brend3n/Pin-Transfer-Robot/Website/robot_pictures/3.JPG

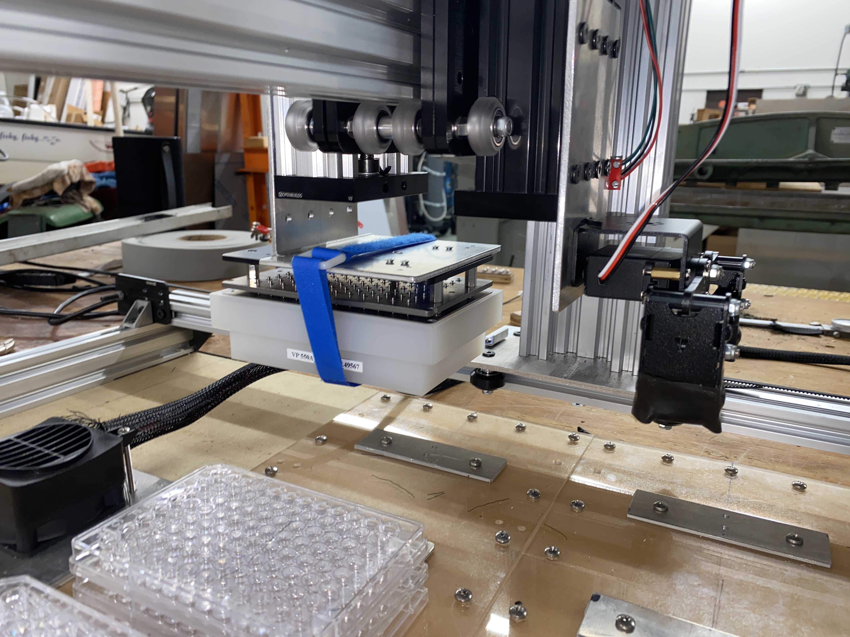
Website/robot_pictures/3.JPG
