brend3n/Pin-Transfer-Robot/Website/robot_pictures/1.JPG

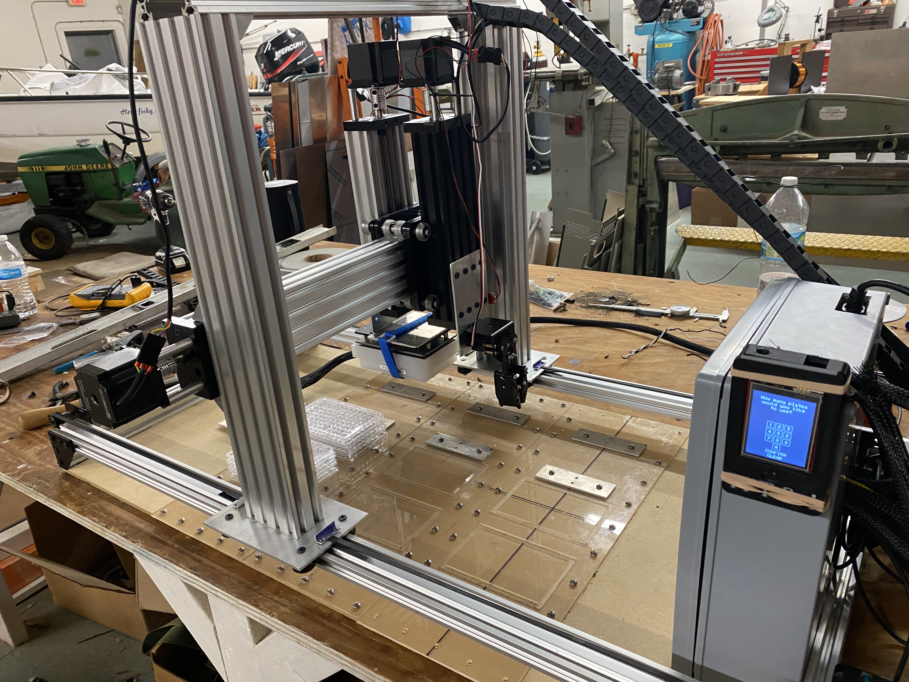
Website/robot_pictures/1.JPG
