brend3n/Pin-Transfer-Robot/README.md

# Pin-Transfer-Robot
Senior Design Project for Group H (Spring 2021 -> Fall 2021)

Checkout our website: https://brend3n.github.io/Group-H-Pin-Transfer-Robot-for-Chemical-Screening/
