brend3n/Pin-Transfer-Robot/Website/VIDEO_LINKS_FOR_IFRAME.txt

FINAL PRESENTATION POWERPOINT
<iframe width="560" height="315" src="https://www.youtube.com/embed/pB1D4pPYYJk" title="YouTube video player" frameborder="0" allow="accelerometer; autoplay; clipboard-write; encrypted-media; gyroscope; picture-in-picture" allowfullscreen></iframe>

FINAL PRESENTATION DEMO
<iframe width="560" height="315" src="https://www.youtube.com/embed/w0Isp63emys" title="YouTube video player" frameborder="0" allow="accelerometer; autoplay; clipboard-write; encrypted-media; gyroscope; picture-in-picture" allowfullscreen></iframe>

SHOWCASE VIDEO
<iframe width="560" height="315" src="https://www.youtube.com/embed/QKIKh7ecDXY" title="YouTube video player" frameborder="0" allow="accelerometer; autoplay; clipboard-write; encrypted-media; gyroscope; picture-in-picture" allowfullscreen></iframe>

MIDTERM DEMO
<iframe width="560" height="315" src="https://www.youtube.com/embed/RnHdhDJ4A94" title="YouTube video player" frameborder="0" allow="accelerometer; autoplay; clipboard-write; encrypted-media; gyroscope; picture-in-picture" allowfullscreen></iframe>

CDR PRESENTATION
<iframe width="560" height="315" src="https://www.youtube.com/embed/KsBtdRXCSqM" title="YouTube video player" frameborder="0" allow="accelerometer; autoplay; clipboard-write; encrypted-media; gyroscope; picture-in-picture" allowfullscreen></iframe>
