brend3n/Pin-Transfer-Robot/Website/robot_pictures/2.JPG

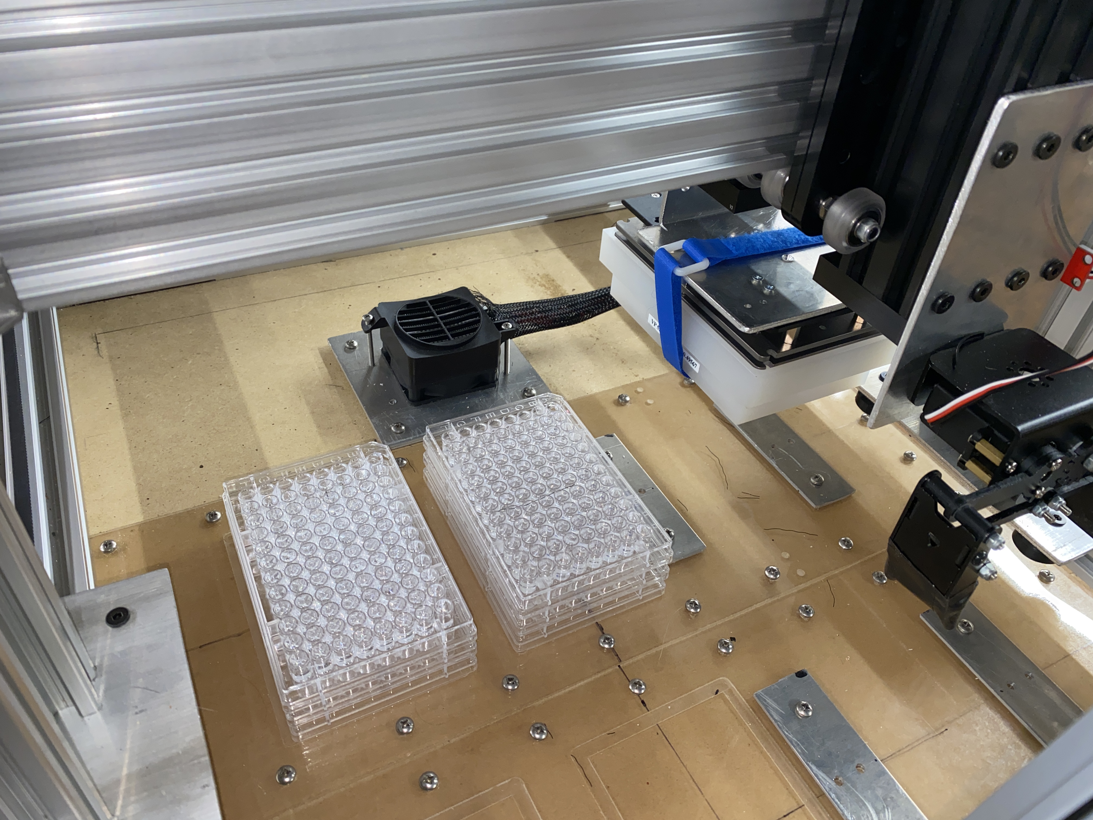
Website/robot_pictures/2.JPG
