brend3n/Pin-Transfer-Robot/test_data/Position_Testing.ods

Positions
 | Name | X | Y | Z1 | Z2
Gripper | Cell Input Stack | 2063 | 3423 | 0 | -1772
 | Cell Output Stack | 873 | 3351 | 0 | -1755
 | Chemical Input Stack | 2063 | 6091 | 0 | -1748
 | Chemical Output Stack | 885 | 6006 | 0 | -1854
Pin tool | Solution 1 | 1451 | 486 | -1680 | 0
 | Solution 2 | 855 | 417 | -1656 | 0
 | Solution 3 | 249 | 334 | -1657 | 0
 | Fan/Heater | 1908 | 3318 | -154 | 0
 | Cell Transfer Area Gripper | 1463 | 3358 | 0 | -1892
 | Chemical Transfer Area Gripper | 1467 | 6051 | 0 | -1748
 | Good Height value for base | -1881
 | Offset | 319
 | Wellplate Height
 | Pins just above well plate entrance |  |  | -1897
 | Pins at bottom of well plate but not pushed |  |  | -2128
 | Red = doesn’t matter
 | Cell Transfer Area Pintool X_LEFT | 846 | 3323
 | Cell Transfer Area Pintool X_RIGHT | 841 | 3267
 | Cell Transfer Area Pintool Y_LEFT | 845 | 3339
 | Cell Transfer Area Pintool Y_RIGHT | 845 | 3223
 | Cell Transfer Area X_MIDPOINT | 843.5
 | Cell Transfer Area Y_MIDPOINT | 3281
 | Chemical Transfer Area Pintool Y_RIGHT | 837 | 5875
 | Chemical Transfer Area Pintool Y_LEFT | 838 | 6023
 | Chemical Transfer Area Pintool X_LEFT | 838 | 5991
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
