brend3n/Pin-Transfer-Robot/PinToolRobot.ino

// Motors
#include <AccelStepper.h>
#include <MultiStepper.h>

// Servos
#include <Servo.h>

// LCD
#include <Adafruit_GFX.h>
#include <MCUFRIEND_kbv.h>
#include <TouchScreen.h>
#include <SoftwareSerial.h>


/*###########################################################################################*/
/* Motor Pin Definitions*/

// Motor driver type
#define interface  1

// Direction and Step pins for all motors
#define dirPinx   40
// #define stepPinx  41
#define stepPinx  52

#define dirPiny   38
#define stepPiny  39

#define dirPinz1  46
#define stepPinz1 47

#define dirPinz2  44
// #define stepPinz2 45
#define stepPinz2 35

/*###########################################################################################*/
/*Position Constants*/

#define Z_HIGH -100
#define Z_WASH_HIGH -800

#define drying_time_ms 10000
#define time_in_solution_ms 1000

#define time_for_full_absorption_of_chemicals_in_ms 1000
#define time_for_full_transfer_of_chemicals_in_ms 1000

#define STEPS_TO_MM  25.455
// #define Plate_Offset 290
#define Plate_Offset 319


// making this negative 
#define BASE_PLATE_STEPS -1881

#define PINS_ABOVE_WELL_PLATE_OPENING_STEPS -1897
#define PINS_AT_BOTTOM_OF_WELL_PLATE_STEPS  -2128

#define Cell_Input_Stack_X 2063
#define Cell_Input_Stack_Y -3423
#define Cell_Input_Stack_Z1 Z_HIGH
#define Cell_Input_Stack_Z2 BASE_PLATE_STEPS

#define Cell_Output_Stack_X 873
#define Cell_Output_Stack_Y -3351
#define Cell_Output_Stack_Z1 Z_HIGH
#define Cell_Output_Stack_Z2 BASE_PLATE_STEPS

#define Chemical_Input_Stack_X 2063
#define Chemical_Input_Stack_Y -6091
//#define Chemical_Output_Stack_X 899
//#define Chemical_Output_Stack_Y 6016

#define Chemical_Output_Stack_X 873
#define Chemical_Output_Stack_Y -6016

#define Cell_Transfer_Area_Gripper_X 1463
#define Cell_Transfer_Area_Gripper_Y -3358
#define Cell_Transfer_Area_Gripper_Z1 Z_HIGH
#define Cell_Transfer_Area_Gripper_Z2 BASE_PLATE_STEPS

#define Chemical_Transfer_Area_Gripper_X 1467
#define Chemical_Transfer_Area_Gripper_Y -6051
#define Chemical_Transfer_Area_Gripper_Z1 Z_HIGH
#define Chemical_Transfer_Area_Gripper_Z2 BASE_PLATE_STEPS

#define Cell_Transfer_Area_Pin_Tool_X 845
#define Cell_Transfer_Area_Pin_Tool_Y -3294

#define Chemical_Transfer_Area_Pin_Tool_X 841
#define Chemical_Transfer_Area_Pin_Tool_Y -5962

#define Solution_1_X 1451
#define Solution_1_Y -486
#define Solution_1_Z1 -1680
#define Solution_1_Z2 Z_HIGH

#define Solution_2_X 855
#define Solution_2_Y -417
#define Solution_2_Z1 -1656
#define Solution_2_Z2 Z_HIGH

#define Solution_3_X 249
#define Solution_3_Y -334
#define Solution_3_Z1 -1657
#define Solution_3_Z2 Z_HIGH

#define Fan_Heater_X 1908
#define Fan_Heater_Y -3318
#define Fan_Heater_Z1 -154
#define Fan_Heater_Z2 Z_HIGH


/*###########################################################################################*/
/*Servo Pins*/
#define SERVO_PIN 10

// Servo constants
#define CLOSE 50
#define OPEN  0

/*###########################################################################################*/
/* LCD Pin Definitions*/
#define YP A3  
#define XM A2  
#define YM 9   
#define XP 8 
TouchScreen ts = TouchScreen(XP, YP, XM, YM, 300);
#define LCD_CS A3
#define LCD_CD A2
#define LCD_WR A1
#define LCD_RD A0
#define LCD_RESET A4
MCUFRIEND_kbv tft;
#define BLACK 0x0000
#define WHITE 0xFFFF


/*###########################################################################################*/
/*Bluetooth*/

#define BLE_RX 22
#define BLE_TX 23


struct Ptr_Ble {
  void set_num_plates(int val);
  void update_state();
  void print_info();
  void send_data();
  void update_and_send();
  
  byte state;
  byte plate_number;
  byte num_plates;
  // enum State {CALIBRATING, CALIBRATED, SRCUNLOADED, RCPUNLOADED, PROCESSED, WASHED, DRIED, SRCLOADED, RCPLOADED, DONE};
  enum State {CALIBRATING, CALIBRATED, SRCUNLOADED, RCPUNLOADED, PROCESSED, SRCLOADED, RCPLOADED, WASHED, DRIED, DONE};

  Ptr_Ble() {
    Serial1.begin(9600);
    state = CALIBRATING;
    plate_number = 0;
    num_plates = -1;
  }
};

// Set this when the LCD gives it to you
void Ptr_Ble::set_num_plates(int val) {
  num_plates = val;
}

// helper
// update according to the states
// shown in the enum
void Ptr_Ble::update_state() {
  if (plate_number == num_plates) {
    if (state == DRIED) {
      state = DONE;
    } else if (state != DONE) {
      state++;
    }

    return;
  }

  if (state == DRIED) {
    if (plate_number == num_plates) {
      state = DONE;
      return;
    }

    plate_number++;
    state = SRCUNLOADED;
    return;
  }

  state++;
}

// for debugging purposes
void Ptr_Ble::print_info() {
  Serial.print("num_plates:"); Serial.print(num_plates); Serial.print(" state:"); Serial.println(state);
}

// helper
void Ptr_Ble::send_data() {
  Serial1.write(plate_number * 10 + state);
  // Just for good measure.
  delay(100);
}

void Ptr_Ble::update_and_send() {
  update_state();
  send_data();
}

void Ptr_Ble::reset() {
  state = CALIBRATING;
  plate_number = 0;
  num_plates = -1;
}

Ptr_Ble ptr_ble;

/*###########################################################################################*/
/*Other Pin Definitions*/

// Limit switch pins definitions
#define y_switch 26
#define x_switch 29
#define z1_switch 25
#define z2_switch 24

// Pins for fan and heater N-Channel MOSFET gate pin
#define fan_pin         34
#define heater_pin      36

/*###########################################################################################*/
/*CONTSTANTS*/

// Motor speeds
#define SPEED_GANTRY 300
#define SPEED_Y      400
#define SPEED_Z      150

#define SPEED_Z1     150
#define SPEED_Z2     150


#define ACCELERATION_Y 200
#define ACCELERATION_GANTRY 200

// Speed of all the motors
#define MAX_SPEED             500
#define MAX_ACCELERATION      100

#define DELAY                 500 // Half a second

#define plate_height_in_steps 1024

#define plate_height_in_mm    1024

#define steps_per_mm          1024

#define heat_and_fan_delay    5000

// Change to false to do polling
#define INTERRUPTS_ENABLED false



/*###########################################################################################*/

// Instantiating motor driver objects
AccelStepper gantry   = AccelStepper(interface, stepPinx, dirPinx);
AccelStepper motor_y  = AccelStepper(interface, stepPiny, dirPiny);
AccelStepper motor_z1 = AccelStepper(interface, stepPinz1, dirPinz1);
AccelStepper motor_z2 = AccelStepper(interface, stepPinz2, dirPinz2);

Servo servo = Servo();

/*###########################################################################################*/

// Converts a distance in mm to steps
long convert_mm_to_steps(float mm){
  long steps = mm * STEPS_TO_MM;
  return steps;
}

// Prints the current position of each motor to the serial for testing and getting position values for hard coding.
void print_current_position(){
    Serial.println("X Position: " + String(gantry.currentPosition()) +"\nY Position: " + String(motor_y.currentPosition()) + "\nZ1 Position: " + String(motor_z1.currentPosition()) +"\nZ2 Position: " + String(motor_z2.currentPosition()) + "\n"); 
}

// WORKING
void set_pins(){

  // Polling inputs
  pinMode(x_switch, INPUT);
  pinMode(y_switch, INPUT);
  pinMode(z1_switch, INPUT);
  pinMode(z2_switch, INPUT);

  pinMode(heater_pin, INPUT);
  pinMode(fan_pin, INPUT);

  // Set up servo
  servo.attach(SERVO_PIN);  
}

// Configure each motor
void configure_motors(){

    // Set maxmium speeds
    gantry.setMaxSpeed(MAX_SPEED);
    motor_y.setMaxSpeed(MAX_SPEED);
    motor_z1.setMaxSpeed(MAX_SPEED);
    motor_z2.setMaxSpeed(MAX_SPEED);

    // Set acceleration
    gantry.setAcceleration(ACCELERATION_GANTRY);
    motor_y.setAcceleration(ACCELERATION_Y);
    motor_z1.setAcceleration(MAX_ACCELERATION);
    motor_z2.setAcceleration(MAX_ACCELERATION);
}

void set_acceleration(int acceleration){
    // Set acceleration
    gantry.setAcceleration(acceleration);
    motor_y.setAcceleration(acceleration);
    motor_z1.setAcceleration(acceleration);
    motor_z2.setAcceleration(acceleration);
}

// Calibrates a single motor given by &motor and a limit switch
long calibrate_motor(AccelStepper *motor, int limit_switch, short dir){

    long steps;
    Serial.println("Start Position:");

    // For testing
    print_current_position();
    
    // Set the current speed and run until the limit switch is hit
    motor->setSpeed(175 * dir);
    while (digitalRead(limit_switch) != LOW){
        motor->runSpeed();
    }

    // Distance from starting position to limit switch
    // Negative because reference 0 is at limit switch and all of other distances are negative relative to the limit switch
    steps = -1*motor->currentPosition();

    // For testing
    Serial.println("Steps taken to reach limit switch: " + String(steps));
    // Stop the motor and store the current position
    motor->stop();
    motor->setCurrentPosition(0);

    // For testing
    Serial.println("End Position:");
    print_current_position();

    // Move the motor off the limit switch
    
    motor->move(50 * -1 * dir);
    motor->runToPosition();

    return steps;
}

// Shows the motor's (x,y,z1,z2) coordinates from where the motor starts before calibration

void calibrate_motors(){ 

  gripper(CLOSE, servo);
  int val;

  Serial.println("Calibrating Z1");
  long z1_start = calibrate_motor(&motor_z1, z1_switch, 1); 

  Serial.println("Calibrating Z2");
  long z2_start = calibrate_motor(&motor_z2, z2_switch, 1); 

  Serial.println("Calibrating Y");
  long y_start = calibrate_motor(&motor_y, y_switch, 1);

  Serial.println("Calibrating gantry");
  long x_start = calibrate_motor(&gantry , x_switch, -1);


  gantry.runToNewPosition(1000);
  gripper(OPEN,servo);
}

// Test code for verifying limit switches are working
void test_limit_switches(){
   Serial.println("X: " + String(digitalRead(x_switch)));
   Serial.println("Y: " + String(digitalRead(y_switch)));
   Serial.println("Z1: " + String(digitalRead(z1_switch)));
   Serial.println("Z2: " + String(digitalRead(z2_switch)));
   Serial.println();
   delay(1000);
}

/*###########################################################################################*/
/*Servo Functions*/

void gripper(int a, Servo x)
{
  int currentPos =  x.read();
  if (currentPos > a)
  {
    for (int angle = currentPos; angle >= a; angle--) {
      x.write(angle);
      delay(15);
    }
  }
  else if (currentPos < a)
  {
    for (int angle = currentPos; angle <= a; angle++) {
      x.write(angle);
      delay(15);
    }
  }
}

// Open gripper arms enough to grab one plate
void open_gripper(){
  gripper(OPEN,servo);
}

// Close gripper arms enough to secure one plate
void close_gripper(){
  gripper(CLOSE, servo);
}

/*###########################################################################################*/
/*Robot Functions*/

// Moves each motor to a given position starting with the x-axis
void move_to_coordinate_x_first(long x, long y, long z1, long z2){
// void move_to_coordinate_x_first(long *coordinates){

  motor_z1.setSpeed(SPEED_Z);
  motor_z2.setSpeed(SPEED_Z);
  gantry.setSpeed(SPEED_GANTRY);
  motor_y.setSpeed(SPEED_Y);
  

  gantry.runToNewPosition(x);
  motor_y.runToNewPosition(y);
  motor_z1.runToNewPosition(z1);
  motor_z2.runToNewPosition(z2);
  
}
// Moves each motor to a given position starting with the z-axis to prevent the pintool/gripper from hitting anything on the workspace
void move_to_coordinate_z_first(long x, long y, long z1, long z2){
// void move_to_coordinate_z_first(long *coordinates){

  motor_z1.setSpeed(SPEED_Z);
  motor_z2.setSpeed(SPEED_Z);
  gantry.setSpeed(SPEED_GANTRY);
  motor_y.setSpeed(SPEED_Y);

  motor_z1.runToNewPosition(z1);
  motor_z2.runToNewPosition(z2);
  gantry.runToNewPosition(x);
  motor_y.runToNewPosition(y);
}

// Take plate from a stack
// stack ==  
//    false for cell
//    true for chemical
void take_from_stack(boolean stack, int height_to_pick_from){

  // chemical stack
  if (stack){
    
    // Position gripper over stack
    // z1 is set to 0 because we dont know height yet of first plate to grab so bring it all the way up
    move_to_coordinate_x_first(Chemical_Input_Stack_X, Chemical_Input_Stack_Y, Z_HIGH, height_to_pick_from);
    // move_to_coordinate_x_first(chemical_stack_1);
    close_gripper();
    // z2 set to 0 to bring plate up ... might change to something else later but 0 for now
    // Moving up gripper
    move_to_coordinate_z_first(Chemical_Input_Stack_X, Chemical_Input_Stack_Y, Z_HIGH, Z_HIGH);
    // Move to pin transfer area
    move_to_coordinate_x_first(Chemical_Transfer_Area_Gripper_X, Chemical_Transfer_Area_Gripper_Y, Z_HIGH, BASE_PLATE_STEPS);
    open_gripper();
    move_to_coordinate_x_first(Chemical_Transfer_Area_Gripper_X, Chemical_Transfer_Area_Gripper_Y, Z_HIGH, Z_HIGH);
  }
  // cell stack
  else{

    // Position gripper over stack
    // z1 is set to 0 because we dont know height yet of first plate to grab so bring it all the way up
    move_to_coordinate_x_first(Cell_Input_Stack_X, Cell_Input_Stack_Y, Z_HIGH, height_to_pick_from);
    close_gripper();
    // z2 set to 0 to bring plate up ... might change to something else later but 0 for now
    // Moving up gripper
    move_to_coordinate_z_first(Cell_Input_Stack_X, Cell_Input_Stack_Y, Z_HIGH, Z_HIGH);
    // Move to pin transfer area
    move_to_coordinate_x_first(Cell_Transfer_Area_Gripper_X, Cell_Transfer_Area_Gripper_Y, Z_HIGH, BASE_PLATE_STEPS);
    open_gripper();
    move_to_coordinate_x_first(Cell_Transfer_Area_Gripper_X, Cell_Transfer_Area_Gripper_Y, Z_HIGH, Z_HIGH);
  }
}

// TODO
// Put a plate onto a stack
void push_onto_stack(int stack, int height_to_put_on){

  // chemical stack
  if (stack){
    // Position gripper over stack
    // z1 is set to 0 because we dont know height yet of first plate to grab so bring it all the way up
    move_to_coordinate_x_first(Chemical_Transfer_Area_Gripper_X, Chemical_Transfer_Area_Gripper_Y, Z_HIGH, BASE_PLATE_STEPS);
    close_gripper();
    // z2 set to 0 to bring plate up ... might change to something else later but 0 for now
    // Moving up gripper
    move_to_coordinate_z_first(Chemical_Transfer_Area_Gripper_X, Chemical_Transfer_Area_Gripper_Y, Z_HIGH, Z_HIGH);
    // Move to pin transfer area
    move_to_coordinate_x_first(Chemical_Output_Stack_X, Chemical_Output_Stack_Y, Z_HIGH, height_to_put_on);
    open_gripper();
    move_to_coordinate_x_first(Chemical_Output_Stack_X, Chemical_Output_Stack_Y, Z_HIGH, Z_HIGH);
  }
  // cell stack
  else{
    // Position gripper over stack
    // z1 is set to 0 because we dont know height yet of first plate to grab so bring it all the way up
    move_to_coordinate_x_first(Cell_Transfer_Area_Gripper_X, Cell_Transfer_Area_Gripper_Y, Z_HIGH, BASE_PLATE_STEPS);
    close_gripper();
    // z2 set to 0 to bring plate up ... might change to something else later but 0 for now
    // Moving up gripper
    move_to_coordinate_z_first(Cell_Transfer_Area_Gripper_X, Cell_Transfer_Area_Gripper_Y, Z_HIGH, Z_HIGH);
    // Move to pin transfer area
    move_to_coordinate_x_first(Cell_Output_Stack_X, Cell_Output_Stack_Y, Z_HIGH, height_to_put_on);
    open_gripper();
    move_to_coordinate_x_first(Cell_Output_Stack_X, Cell_Output_Stack_Y, Z_HIGH, Z_HIGH);
  }
}

// TODO
void do_wash(int wash_step){

  set_acceleration(200);

  
  // Solution 1
  if(wash_step == 0){
    // Move to Solution 1
    for(int i = 0; i < 3; i++){
      
      move_to_coordinate_x_first(Solution_1_X, Solution_1_Y, Solution_1_Z1, Z_HIGH);
      delay(time_in_solution_ms);
      move_to_coordinate_x_first(Solution_1_X, Solution_1_Y, Z_WASH_HIGH, Z_HIGH);  
    }
  }
  // Solution 2
  else if(wash_step == 1){
    // Move to Solution 2
    for(int i = 0; i < 3;i++){
      move_to_coordinate_x_first(Solution_2_X, Solution_2_Y, Solution_2_Z1, Z_HIGH);
      delay(time_in_solution_ms);
      move_to_coordinate_x_first(Solution_2_X, Solution_2_Y, Z_WASH_HIGH, Z_HIGH);     
    }
  }
  // Solution 3
  else if(wash_step == 2){
    // Move to Solution 3
    for(int i = 0;i < 3; i++){
      move_to_coordinate_x_first(Solution_3_X, Solution_3_Y, Solution_3_Z1, Z_HIGH);
      delay(time_in_solution_ms);
      move_to_coordinate_x_first(Solution_3_X, Solution_3_Y, Z_WASH_HIGH, Z_HIGH);   
    }
  }

  set_acceleration(MAX_ACCELERATION);
}

// WORKS
// Allows fan to draw from power supply
void fan_on(){
  digitalWrite(fan_pin, HIGH);
}

// WORKS
// Allows heater to draw from power supply
void heat_on(){
  digitalWrite(heater_pin, HIGH);
}

// WORKS
// Turns off the fan.
void fan_off(){
  digitalWrite(fan_pin, LOW);
}

// WORKS
// Turns off the heater.
void heat_off(){
  digitalWrite(heater_pin, LOW);
}

// WORKS
// Allows fan and hearter to draw from power supply
void do_fan_and_heat(){
  
  // Move pin tool over the fan
  move_to_coordinate_x_first(Fan_Heater_X, Fan_Heater_Y, Fan_Heater_Z1, Z_HIGH);
  fan_on();
  heat_on();
  delay(drying_time_ms);
  heat_off();
  fan_off();
  delay(drying_time_ms);
  move_to_coordinate_x_first(Fan_Heater_X , Fan_Heater_Y, Z_HIGH, Z_HIGH);
}

// TODO
// Perform a single pin transfer and bring the pin back to its starting position.
void do_pin_transfer(int pin_depth){

  long depth =  PINS_ABOVE_WELL_PLATE_OPENING_STEPS - convert_mm_to_steps(pin_depth);
  

  // Move to chemical plate to absorb chemicals in pin tool also dipping pin tool in chemical plate
  move_to_coordinate_x_first(Chemical_Transfer_Area_Pin_Tool_X,Chemical_Transfer_Area_Pin_Tool_Y, depth, Z_HIGH);
  delay(time_for_full_absorption_of_chemicals_in_ms);

  // Moving pin tool out of chemical plate
  move_to_coordinate_z_first(Chemical_Transfer_Area_Pin_Tool_X, Chemical_Transfer_Area_Pin_Tool_Y, Z_HIGH,Z_HIGH);
  // Moving pin tool to cell plate and transfer chemicals to cells
  move_to_coordinate_x_first(Cell_Transfer_Area_Pin_Tool_X, Cell_Transfer_Area_Pin_Tool_Y, depth, Z_HIGH);
  delay(time_for_full_transfer_of_chemicals_in_ms);
  // Moving pin tool out of cell plate
  move_to_coordinate_z_first(Cell_Transfer_Area_Pin_Tool_X, Cell_Transfer_Area_Pin_Tool_Y, Z_HIGH, Z_HIGH);

}

// Wash the pin tool.
void wash_pin_tool(boolean * wash_steps){
  // 1. Move pin tool to wash step linear actuator
  for(int wash_step = 0; wash_step < 3; wash_step++){
    if(wash_steps[wash_step]){
      do_wash(wash_step);
    }
  }
}


void do_cycle(boolean *wash_steps, int pin_depth, int grab_height, int stack_height, int plateNum){
  progressScreen(plateNum, "Input");
  take_from_stack(true, grab_height);
  ptr_ble.update_and_send();
  take_from_stack(false, grab_height);
  ptr_ble.update_and_send();

  progressScreen(plateNum, "Transfer");
  do_pin_transfer(pin_depth);
  ptr_ble.update_and_send();

  progressScreen(plateNum, "Output");
  push_onto_stack(false, stack_height);
  ptr_ble.update_and_send();
  push_onto_stack(true, stack_height);
  ptr_ble.update_and_send();

  progressScreen(plateNum, "Wash");
  wash_pin_tool(wash_steps);
  ptr_ble.update_and_send();

  progressScreen(plateNum, "Dry");
  do_fan_and_heat();
  ptr_ble.update_and_send();
  
}

void run_all_cycles(boolean * wash_steps, short num_plates, int pin_depth ){

  int grab_height = (BASE_PLATE_STEPS + (Plate_Offset * (num_plates - 1)));
  int stack_height = BASE_PLATE_STEPS;
  
  for(int i = 0; i < num_plates; i++){
    
    do_cycle(wash_steps, pin_depth, grab_height, stack_height , i+1);

    // Update where the next plate is located at.
    grab_height -= Plate_Offset;
    stack_height += Plate_Offset;

  }
}

/*###########################################################################################*/
/*LCD Functions*/
void lcd_startup()
{
  tft.reset();
  uint16_t identifier = tft.readID();
  tft.begin(identifier);
  tft.setRotation(2);
  tft.setTextColor(WHITE);
  tft.setTextSize(2);
  pinMode(13, OUTPUT);
}

void greeting()
{
  tft.fillScreen(BLACK);
  tft.setCursor(40,120);
  tft.println("Welcome to the");
  tft.setCursor(43,140);
  tft.println("automated Pin");
  tft.setCursor(40,160);
  tft.println("Transfer Tool!");
  delay(3000);
}

// Screen setup for plate input
void plateNumberSetup()
{
  // Reset screen
  tft.fillScreen(BLACK);
  // Instructions
  tft.setCursor(33,20);
  tft.println("How many plates");
  tft.setCursor(38,40);
  tft.println("would you like");
  tft.setCursor(75,60);
  tft.println("to use?");
  
  // Buttons
  tft.drawRect(70, 135, 30, 30, WHITE);
  tft.setCursor(80,143);
  tft.println("1");
  tft.drawRect(105, 135, 30, 30, WHITE);
  tft.setCursor(115,143);
  tft.println("2");
  tft.drawRect(140, 135, 30, 30, WHITE);
  tft.setCursor(150,143);
  tft.println("3");
  tft.drawRect(70, 170, 30, 30, WHITE);
  tft.setCursor(80,178);
  tft.println("4");
  tft.drawRect(105, 170, 30, 30, WHITE);
  tft.setCursor(115,178);
  tft.println("5");
  tft.drawRect(140, 170, 30, 30, WHITE);
  tft.setCursor(150,178);
  tft.println("6");
  tft.drawRect(70, 205, 30, 30, WHITE);
  tft.setCursor(80,213);
  tft.println("7");
  tft.drawRect(105, 205, 30, 30, WHITE);
  tft.setCursor(115,213);
  tft.println("8");
  tft.drawRect(140, 205, 30, 30, WHITE);
  tft.setCursor(150,213);
  tft.println("9");
  tft.drawRect(105, 240, 30, 30, WHITE);
  tft.setCursor(115,248);
  tft.println("0");
  tft.setCursor(80, 278);
  tft.println("CONFIRM");
  tft.setCursor(90, 300);
  tft.println("CLEAR");
}

// User inputs number of plates they wish to use
int plateNumberInput()
{
  int plateNum = -1;
  while (true)
  {
    digitalWrite(13, HIGH);
    TSPoint point = ts.getPoint();
    digitalWrite(13, LOW);
    pinMode(XM, OUTPUT);
    pinMode(YP, OUTPUT);
    if (point.z  >= 200 && point.z <= 1500)
    {
      int x = map(point.x, 78, 951, 0, 320);
      int y = map(point.y, 96, 921, 0, 240);

      if (x >= 185 && x <= 220 && y >= 109 && y <= 127)
      {
        tft.fillRect(105, 90, 30, 30, BLACK);
        plateNum = 1;
        tft.setCursor(115, 100);
        tft.print("1");
        delay(1000);
      }
      else if (x >= 140 && x <= 175 && y >= 107 && y <= 129)
      {
        tft.fillRect(105, 90, 30, 30, BLACK);
        plateNum = 2;
        tft.setCursor(115, 100);
        tft.print("2");
        delay(1000);
      }
      else if (x >= 95 && x <= 132 && y >= 107 && y <= 129)
      {
        tft.fillRect(105, 90, 30, 30, BLACK);
        tft.setCursor(115, 100);
        tft.print("3");
        plateNum = 3;
        delay(1000);
      }
      else if (x >= 185 && x <= 220 && y >= 80 && y <= 101)
      {
        tft.fillRect(105, 90, 30, 30, BLACK);
        tft.setCursor(115, 100);
        tft.print("4");
        plateNum = 4;
        delay(1000);
      }
      else if (x >= 140 && x <= 175 && y >= 80 && y <= 101)
      {
        tft.fillRect(105, 90, 30, 30, BLACK);
        tft.setCursor(115, 100);
        tft.print("5");
        plateNum = 5;
        delay(1000);
      }
      else if (x >= 95 && x <= 132 && y >= 80 && y <= 101)
      {
        tft.fillRect(105, 90, 30, 30, BLACK);
        tft.setCursor(115, 100);
        tft.print("6");
        plateNum = 6;
        delay(1000);
      }
      else if (x >= 185 && x <= 220 && y >= 55 && y <= 75)
      {
        tft.fillRect(105, 90, 30, 30, BLACK);
        tft.setCursor(115, 100);
        tft.print("7");
        plateNum = 7;
        delay(1000);
      }
      else if (x >= 140 && x <= 175 && y >= 55 && y <= 75)
      {
        tft.fillRect(105, 90, 30, 30, BLACK);
        tft.setCursor(115, 100);
        tft.print("8");
        plateNum = 8;
        delay(1000);
      }
      else if (x >= 95 && x <= 132 && y >= 55 && y <= 75)
      {
        tft.fillRect(105, 90, 30, 30, BLACK);
        tft.setCursor(115, 100);
        tft.print("9");
        plateNum = 9;
        delay(1000);
      }
      else if (x >= 140 && x <= 175 && y >= 28 && y <= 50)
      {
        tft.fillRect(105, 90, 30, 30, BLACK);
        tft.setCursor(115, 100);
        tft.print("0");
        plateNum = 0;
        delay(1000);
      }
      else if (x >= 103 && x <= 208 && y >= 13 && y <= 22 && plateNum != -1)
        break;
      else if (x >= 120 && x <= 195 && y >= -2 && y <= 6)
      {
        plateNum = -1;
        tft.fillRect(105, 90, 30, 30, BLACK);
      }
    }
  }

  ptr_ble.set_num_plates(plateNum);

  return plateNum;
}

void depthSetup()
{
  // Reset screen
  tft.fillScreen(BLACK);
  // Instructions
  tft.setCursor(33,20);
  tft.println("How deep would");
  tft.setCursor(13,40);
  tft.println("you like to insert");
  tft.setCursor(40,60);
  tft.println("the pin tool?");
  
  // Buttons
  tft.drawRect(70, 135, 30, 30, WHITE);
  tft.setCursor(80,143);
  tft.println("1");
  tft.drawRect(105, 135, 30, 30, WHITE);
  tft.setCursor(115,143);
  tft.println("2");
  tft.drawRect(140, 135, 30, 30, WHITE);
  tft.setCursor(150,143);
  tft.println("3");
  tft.drawRect(70, 170, 30, 30, WHITE);
  tft.setCursor(80,178);
  tft.println("4");
  tft.drawRect(105, 170, 30, 30, WHITE);
  tft.setCursor(115,178);
  tft.println("5");
  tft.drawRect(140, 170, 30, 30, WHITE);
  tft.setCursor(150,178);
  tft.println("6");
  tft.drawRect(70, 205, 30, 30, WHITE);
  tft.setCursor(80,213);
  tft.println("7");
  tft.drawRect(105, 205, 30, 30, WHITE);
  tft.setCursor(115,213);
  tft.println("8");
  tft.drawRect(140, 205, 30, 30, WHITE);
  tft.setCursor(150,213);
  tft.println("9");
  tft.drawRect(105, 240, 30, 30, WHITE);
  tft.setCursor(115,248);
  tft.println("0");
  tft.setCursor(80, 278);
  tft.println("CONFIRM");
  tft.setCursor(90, 300);
  tft.println("CLEAR");
}

int depthInput()
{
  String depth = "";
  int x_cursor = 115;
  while (true)
  {
    digitalWrite(13, HIGH);
    TSPoint point = ts.getPoint();
    digitalWrite(13, LOW);
    pinMode(XM, OUTPUT);
    pinMode(YP, OUTPUT);
    if (point.z  >= 200 && point.z <= 1500)
    {     
      int x = map(point.x, 78, 951, 0, 320);
      int y = map(point.y, 96, 921, 0, 240);

      if (x >= 185 && x <= 220 && y >= 109 && y <= 127)
      {
        tft.fillRect(0, 90, 240, 30, BLACK);
        tft.setCursor(x_cursor, 100);
        x_cursor -= 7;
        depth.concat("1");
        tft.print(depth);
        delay(1000);
      }
      else if (x >= 140 && x <= 175 && y >= 107 && y <= 129)
      {
        tft.fillRect(0, 90, 240, 30, BLACK);
        tft.setCursor(x_cursor, 100);
        x_cursor -= 7;
        depth.concat("2");
        tft.print(depth);
        delay(1000);
      }
      else if (x >= 95 && x <= 132 && y >= 107 && y <= 129)
      {
        tft.fillRect(0, 90, 240, 30, BLACK);
        tft.setCursor(x_cursor, 100);
        x_cursor -= 7;
        depth.concat("3");
        tft.print(depth);
        delay(1000);
      }
      else if (x >= 185 && x <= 220 && y >= 80 && y <= 101)
      {
        tft.fillRect(0, 90, 240, 30, BLACK);
        tft.setCursor(x_cursor, 100);
        x_cursor -= 7;
        depth.concat("4");
        tft.print(depth);
        delay(1000);
      }
      else if (x >= 140 && x <= 175 && y >= 80 && y <= 101)
      {
        tft.fillRect(0, 90, 240, 30, BLACK);
        tft.setCursor(x_cursor, 100);
        x_cursor -= 7;
        depth.concat("5");
        tft.print(depth);
        delay(1000);
      }
      else if (x >= 95 && x <= 132 && y >= 80 && y <= 101)
      {
        tft.fillRect(0, 90, 240, 30, BLACK);
        tft.setCursor(x_cursor, 100);
        x_cursor -= 7;
        depth.concat("6");
        tft.print(depth);
        delay(1000);
      }
      else if (x >= 185 && x <= 220 && y >= 55 && y <= 75)
      {
        tft.fillRect(0, 90, 240, 30, BLACK);
        tft.setCursor(x_cursor, 100);
       x_cursor -= 7;
        depth.concat("7");
        tft.print(depth);
        delay(1000);
      }
      else if (x >= 140 && x <= 175 && y >= 55 && y <= 75)
      {
        tft.fillRect(0, 90, 240, 30, BLACK);
        tft.setCursor(x_cursor, 100);
        x_cursor -= 7;
        depth.concat("8");
        tft.print(depth);
        delay(1000);
      }
      else if (x >= 95 && x <= 132 && y >= 55 && y <= 75)
      {
        tft.fillRect(0, 90, 240, 30, BLACK);
        tft.setCursor(x_cursor, 100);
        x_cursor -= 7;
        depth.concat("9");
        tft.print(depth);
        delay(1000);
      }
      else if (x >= 140 && x <= 175 && y >= 28 && y <= 50)
      {
        tft.fillRect(0, 90, 240, 30, BLACK);
        tft.setCursor(x_cursor, 100);
        x_cursor -= 7;
        depth.concat("0");
        tft.print(depth);
        delay(1000);
      }
      else if (x >= 103 && x <= 208 && y >= 13 && y <= 22 && depth != "")
        break;
      else if (x >= 120 && x <= 195 && y >= -2 && y <= 6)
      {
        x_cursor = 115;
        depth = "";
        tft.fillRect(0, 90, 240, 30, BLACK);
      }
    }
  }
  return depth.toInt();
}

void washStepSetup()
{
  // Reset screen
  tft.fillScreen(BLACK);
  // Instructions
  tft.setCursor(19, 20);
  tft.println("Select which wash");
  tft.setCursor(30, 40);
  tft.println("steps you would");
  tft.setCursor(47, 60);
  tft.println("like to use.");

  // Check boxes
  tft.drawRect(150, 115, 30, 30, WHITE);
  tft.drawRect(150, 165, 30, 30, WHITE);
  tft.drawRect(150, 215, 30, 30, WHITE);

  // Wash step numbers
  tft.setCursor(55, 123);
  tft.print("1 -----");
  tft.setCursor(55, 173);
  tft.print("2 -----");
  tft.setCursor(55, 223);
  tft.print("3 -----");
  tft.setCursor(80, 280);
  tft.print("CONFIRM");
}

void washStepInput(bool * steps)
{
  steps[0] = false;
  steps[1] = false;
  steps[2] = false;
      
  while (true)
  {
    digitalWrite(13, HIGH);
    TSPoint point = ts.getPoint();
    digitalWrite(13, LOW);
    pinMode(XM, OUTPUT);
    pinMode(YP, OUTPUT);
    if (point.z  >= 200 && point.z <= 1500)
    {
      int x = map(point.x, 78, 951, 0, 320);
      int y = map(point.y, 96, 921, 0, 240);

      if (x >= 83 && x <= 119 && y >= 122 && y <= 145)
      {
        if (!steps[0])
        {
          tft.drawLine(151, 116, 178, 143, WHITE);
          tft.drawLine(178, 116, 151, 143, WHITE);
          steps[0] = true;
          delay(500);
        }
        else
        {
          tft.fillRect(151, 116, 28, 28, BLACK);
          steps[0] = false;
          delay(500);
        }         
      }
      else if (x >= 83 && x <= 119 && y >= 83 && y <= 108)
      { 
        if (!steps[1])
        {
          tft.drawLine(151, 166, 178, 193, WHITE);
          tft.drawLine(178, 166, 151, 193, WHITE);
          steps[1] = true;
          delay(500);
        }
        else
        {
          tft.fillRect(151, 166, 28, 28, BLACK);
          steps[1] = false;
          delay(500);
        }      
      }
      else if (x >= 83 && x <= 119 && y >= 45 && y <= 70)
      {  
        if (!steps[2])
        {
          tft.drawLine(151, 216, 178, 243, WHITE);
          tft.drawLine(178, 216, 151, 243, WHITE);
          steps[2] = true;
          delay(500);
        }
        else
        {
          tft.fillRect(151, 216, 28, 28, BLACK);
          steps[2] = false;
          delay(500);
        }     
      }
      else if (x >= 105 && x <= 211 && y >= 10 && y <= 22) 
        break;
    }
  }
}

bool paramCheck(int plateNum, int depth, bool * steps)
{
  tft.fillScreen(BLACK);
  tft.setCursor(19, 20);
  tft.println("Accept parameters");
  tft.setCursor(50, 40);
  tft.println("and continue");
  tft.setCursor(62, 60);
  tft.println("to the pin");
  tft.setCursor(20, 80);
  tft.println("transfer process?");

  tft.setCursor(0, 140);
  tft.print("Number of Plates: ");
  tft.print(plateNum);
  tft.setCursor(0, 160);
  tft.print("Pin Tool Depth: ");
  tft.print(depth);
  tft.setCursor(0, 180);
  tft.print("Wash Steps: ");
  if (steps[0] == 1)
    tft.print("1 ");
  if (steps[1] == 1)
    tft.print("2 ");
  if (steps[2] == 1)
    tft.print("3 ");

  tft.setCursor(20, 240);
  tft.print("CONFIRM");
  tft.setCursor(173, 240);
  tft.print("REDO");

  while (true)
  {
    digitalWrite(13, HIGH);
    TSPoint point = ts.getPoint();
    digitalWrite(13, LOW);
    pinMode(XM, OUTPUT);
    pinMode(YP, OUTPUT);
    if (point.z  >= 200 && point.z <= 1500)
    {
      int x = map(point.x, 78, 951, 0, 320);
      int y = map(point.y, 96, 921, 0, 240);

      if (x >= 182 && x <= 283 && y >= 37 && y <= 50)
        return true;
      else if (x >= 35 && x <= 93 && y >= 37 && y <= 50)
        return false;
    }
  }
  return false;
}

void progressScreen(int plateNum, String location)
{
  tft.fillRect(154, 115, 30, 30, BLACK);
  tft.fillRect(130, 155, 120, 30, BLACK);
  tft.setCursor(70, 120);
  tft.print("Plate #");
  tft.print(plateNum);
  tft.setCursor(20, 160);
  tft.print("Location: ");
  tft.print(location);
}

void redo()
{
  tft.fillScreen(BLACK);
  tft.setCursor(25, 120);
  tft.print("Run more plates?");
  tft.setCursor(80, 170);
  tft.print("CONFIRM");
  tft.drawRect(75, 165, 92, 25, WHITE);

  while (true)
  {
    digitalWrite(13, HIGH);
    TSPoint point = ts.getPoint();
    digitalWrite(13, LOW);
    pinMode(XM, OUTPUT);
    pinMode(YP, OUTPUT);
    if (point.z  >= 200 && point.z <= 1500)
    {
      int x = map(point.x, 78, 951, 0, 320);
      int y = map(point.y, 96, 921, 0, 240);
      Serial.println(x);
      Serial.println(y);
      Serial.println();
      if (x >= 106 && x <= 214 && y >= 90 && y <= 105)
        break;
    }
  }
}

/*###########################################################################################*/

void run_startup(){
  // TESTING: Begin serial connection for debugging
  Serial.begin(9600);

  // LCD Startup function
  lcd_startup();
  greeting();

  // Set the state of any pins used as inputs
  set_pins();

  // Set the max speed and acceleration values for each motor
  configure_motors();

//   Serial.println("Press x_limit_switch to start calibration");
//   while(true){
//     servo.write(0);
//       Serial.println("Starting calibration.");
//       break;
//     }
//   }
}


void test_directions(){


  motor_z2.setCurrentPosition(0);
  gripper(OPEN, servo);
  motor_z2.runToNewPosition(-50);

  delay(2000);
  gripper(CLOSE, servo);
  
  motor_z2.runToNewPosition(50);
 
delay(2000);



  
}
void setup() {
  Serial.begin(9600);
  run_startup();
}

void loop() {
  ptr_ble.reset();

  int numPlates;
  int depth;
  bool steps[3];
  while (true)
  {
    tft.fillScreen(BLACK);
    plateNumberSetup();
    numPlates = plateNumberInput();
    depthSetup();
    depth = depthInput();
    washStepSetup();
    washStepInput(steps);
    if (paramCheck(numPlates, depth, steps))
      tft.fillScreen(BLACK);
      progressScreen(0, "Waiting");
      break;
  }
    // Find reference positions
    ptr_ble.send_data();
    calibrate_motors();
    ptr_ble.update_and_send();

  run_all_cycles(steps, numPlates, depth);

  redo();
}
