brend3n/Pin-Transfer-Robot/(commit log)

2021-09-15 Initial work that I have... Need to refactor button code to use interrupts instead
2021-09-15 Shows current position
2021-11-03 Added some code for Linear Actuator class but unsure if will go through with it
2021-11-03 Fixed some pointer errors in take_step_until_bound function calls and function definition
    [PinToolRobot.ino]
2021-11-04 TESTING all but calibration
2021-11-07 Added fan_on(), fan_off(), heat_on(), heat_off()
2021-11-08 Added some code to the linear actuator class and some more pin definitions
2021-11-08 Fixed find_bound() to properly check fif the motor stopped
    [PinToolRobot.ino]
2021-11-09 Working on hall effect sensors to use as limit switches and homing sensors
2021-11-11 Added code for moving motor with joystick
2021-11-12 Robot acts as claw machine with this code
2021-11-15 Removed unecessary code and added support for gantry motor grouping and additional z-axis
2021-11-16 Added printCurrentPositions() in SimpleExample
2021-11-17 Changed some motor_x1 instances to gantry
2021-11-17 Added gripper_movement_test()
2021-11-17 x limit_switch needs to be activated to start calibration
2021-11-17 Updating the current code
2021-11-18 Added z1 and z2 limit switch and motor instantiations in SimpleExample ... Also renaming files
2021-11-18 Created some helper functions for testing and added constants for motor speeds
2021-11-20 Testing limit switch pins
2021-11-21 Adding logic for pin transfer
2021-11-21 Fixed all errors in PinToolRobot
    [PinToolRobot_Initial.ino]
2021-11-23 Changed the height that the z-axis motors move up when moving across the workspace from 0 to -100 since 0 would be the limit switch
2021-11-23 Moved the z-axis motors up and out of the way after putting a plate onto the stack or taking a plate after a stack
2021-11-23 Fixed number of parameters in move_to_coordinate functions
    [PinToolRobot_Initial.ino]
2021-11-23 Fixed the move_to_coordinate functions
    [PinToolRobot_Initial.ino]
2021-11-23 Adding excel file for storing position values
    [Position_Testing.ods]
2021-11-23 Fixed a bug with counting.
    [HM-10_Test.ino]
2021-11-23 Continue using get_absolute_positions() for getting position data
    [Position_Testing.ods]
2021-11-23 Renamed files appropriately
    [Position_Testing.ods]
2021-11-23 Added some more test code to Robot Test
    [Position_Testing.ods]
2021-11-23 Added stacking_test() and adjusted the speed and acceleration of the motors
2021-11-23 Added the offset to the excel spreadsheet
    [Position_Testing.ods]
2021-11-24 Added more position values
    [Position_Testing.ods]
2021-11-24 All position data
    [Position_Testing.ods]
2021-11-24 Dominic changed a value from 9 to 8 in plateNumberInput()
2021-11-24 Yousef and Dominic fixed things
    [PinToolRobot.ino]
2021-11-24 My code and dominics code work
    [Position_Testing.ods]
2021-11-24 Removed runToPosition after calibration
2021-11-26 Removed LCD code for now since this code currently works
    [Position_Testing.ods]
2021-11-26 Fixed error where wash steps only dipped once into solution
    [PinToolRobot.ino]
2021-11-29 Everything works: PinToolRobot.ino is current code on robot
2021-11-30 Fixed issue in which BLE would stay at done if researcher wanted a redo()
    [PinToolRobot.ino]
